SharoonSharif/conv3x3-engine-zynq/eval/results/bsds500_test_20_per_image.csv

precision | image | P_at_ODS | R_at_ODS | F_at_ODS | Pratt_at_ODS
fixed | 2018 | 0.6870364220081921 | 0.8612934767425618 | 0.764359054278603 | 0.5367017408046387
fixed | 16004 | 0.5290049942374183 | 0.8123926307683194 | 0.6407641566478511 | 0.32900443195014206
fixed | 36046 | 0.6471093302804808 | 0.7343235389086212 | 0.6879633807342148 | 0.24080708323318759
fixed | 49024 | 0.28222996515679444 | 0.30790378006872854 | 0.2945084019461837 | 0.07121425169083538
fixed | 71076 | 0.6425079702444209 | 0.750150908192943 | 0.6921694104170882 | 0.24130180233635037
fixed | 87015 | 0.378499296944906 | 0.9480286738351255 | 0.541003573892538 | 0.3462389215678983
fixed | 103006 | 0.26762669184765503 | 0.7504831436547134 | 0.3945533458570977 | 0.24670746153862197
fixed | 107072 | 0.46877335326144975 | 0.8884453890415219 | 0.6137249821704819 | 0.36808515852920093
fixed | 118072 | 0.48508339206013623 | 0.7509519779987307 | 0.5894238006223791 | 0.25748576975213117
fixed | 140088 | 0.8420616849513558 | 0.5967291351414271 | 0.6984792146009826 | 0.30735752032771074
fixed | 157087 | 0.5547136390474317 | 0.8610362237145238 | 0.6747357701685337 | 0.37057483303694283
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
