SharoonSharif/conv3x3-engine-zynq/eval/results/bsds500_test_all_per_image.csv

precision | image | P_at_ODS | R_at_ODS | F_at_ODS | Pratt_at_ODS
fixed | 2018 | 0.6797081526911283 | 0.874493644363738 | 0.7648948298438049 | 0.5549249914310739
fixed | 3063 | 0.9211590296495957 | 0.7142238579779173 | 0.8045990464312358 | 0.2166339705734296
fixed | 5096 | 0.49911504424778763 | 0.77013161985698 | 0.6056888521234021 | 0.3276910615426711
fixed | 6046 | 0.5028571428571429 | 0.9016730261226886 | 0.6456432645184711 | 0.37074812587136047
fixed | 8068 | 0.8209654178674352 | 0.8732321131447587 | 0.8462925409115006 | 0.322854539607317
fixed | 10081 | 0.6203842689882918 | 0.8049906670596326 | 0.7007328863391723 | 0.5168496925627778
fixed | 14085 | 0.6111111111111112 | 0.6960817429488262 | 0.6508347808610517 | 0.26806690602676225
fixed | 14092 | 0.4028791988316295 | 0.6016597510373444 | 0.48260189114375246 | 0.14596691010159193
fixed | 15011 | 0.6806006493506493 | 0.8952547452547452 | 0.77330821475178 | 0.35446340461068215
fixed | 15062 | 0.3157340201357996 | 0.6384375406213441 | 0.42251615872105236 | 0.23288722410679968
fixed | 16004 | 0.5271758436944938 | 0.8288016112789527 | 0.6444416713254187 | 0.352606839599231
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
