SharoonSharif/conv3x3-engine-zynq/eval/results/bsds500_test_all_prewitt_k2_per_image.csv

precision | image | P_at_ODS | R_at_ODS | F_at_ODS | Pratt_at_ODS | sat_frac
fixed | 2018 | 0.6750149670724407 | 0.8788937002374634 | 0.7635795006575489 | 0.5846174924994703 | 0.0
fixed | 3063 | 0.912358133669609 | 0.7154145919030093 | 0.8019723043817711 | 0.22852786240909428 | 0.0
fixed | 5096 | 0.5005750130684788 | 0.7803917504404602 | 0.6099215402048023 | 0.348458119525327 | 0.0
fixed | 6046 | 0.5116435074269287 | 0.9007337833871442 | 0.6525941689766143 | 0.38753120104410216 | 0.0
fixed | 8068 | 0.8163538873994638 | 0.8863352745424293 | 0.849906445738774 | 0.34466874244908935 | 0.0
fixed | 10081 | 0.6139112903225806 | 0.8131447096964338 | 0.6996203623993263 | 0.5292124793725987 | 0.0
fixed | 14085 | 0.6216216216216216 | 0.6679614929910488 | 0.6439589689860469 | 0.2507756605006652 | 0.0
fixed | 14092 | 0.4091643116673395 | 0.6063278008298755 | 0.4886058576294617 | 0.15287417466364034 | 0.0
fixed | 15011 | 0.6819984139571769 | 0.8905594405594406 | 0.7724486882968428 | 0.36418181490669854 | 0.0
fixed | 15062 | 0.31489136195018547 | 0.6560509554140127 | 0.4255346072871791 | 0.256494774234777 | 0.0
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
