SharoonSharif/conv3x3-engine-zynq/eval/results/bsds500_test_all_prewitt_k3_per_image.csv

precision | image | P_at_ODS | R_at_ODS | F_at_ODS | Pratt_at_ODS | sat_frac
fixed | 2018 | 0.6777241656614394 | 0.8726079061321413 | 0.7629171529023512 | 0.5824459388959009 | 0.0
fixed | 3063 | 0.9132052076875388 | 0.7167135743667461 | 0.803115561018505 | 0.23271766918081513 | 0.0
fixed | 5096 | 0.5008247422680412 | 0.7804953881231216 | 0.6101385474663937 | 0.35343947826349575 | 0.0
fixed | 6046 | 0.511439600790886 | 0.901496918109774 | 0.6526283633337003 | 0.39438064815626667 | 0.0
fixed | 8068 | 0.8211272359095512 | 0.8819675540765392 | 0.850460683808082 | 0.3444760943311227 | 0.0
fixed | 10081 | 0.6190063547082612 | 0.80970625798212 | 0.7016293055524357 | 0.5332193831138046 | 0.0
fixed | 14085 | 0.6234029608598661 | 0.669059280526938 | 0.6454247143401668 | 0.2558519263619676 | 0.0
fixed | 14092 | 0.4160944206008584 | 0.5816260373443983 | 0.4851285690053865 | 0.14622418645937404 | 0.0
fixed | 15011 | 0.6820959563125731 | 0.8913086913086913 | 0.7727930066649351 | 0.3702356348895659 | 0.0
fixed | 15062 | 0.3169050850997181 | 0.6567658910698038 | 0.4275211148202722 | 0.262339835768778 | 0.0
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
