SharoonSharif/conv3x3-engine-zynq/eval/results/bsds500_test_all_scharr_k4_per_image.csv

precision | image | P_at_ODS | R_at_ODS | F_at_ODS | Pratt_at_ODS | sat_frac
fixed | 2018 | 0.6628465079831521 | 0.8926526051124458 | 0.7607740270109483 | 0.5825778569263603 | 0.005064734036696654
fixed | 3063 | 0.9082217973231358 | 0.722342498376272 | 0.8046873145554555 | 0.2266778466379412 | 0.00042098172939294433
fixed | 5096 | 0.5310211946050096 | 0.699191626075241 | 0.6036119381864188 | 0.20113682737249083 | 0.0
fixed | 6046 | 0.4920664726316778 | 0.907601995890813 | 0.6381518519780623 | 0.3803395470771815 | 0.0005375612852248366
fixed | 8068 | 0.803946132164109 | 0.9000623960066556 | 0.8492934982581222 | 0.364008017963146 | 0.0023898808945537918
fixed | 10081 | 0.6683721811635399 | 0.736712840161116 | 0.7008805309239702 | 0.4362648380711895 | 0.0
fixed | 14085 | 0.6436866814924636 | 0.6466813038338118 | 0.6451805177772643 | 0.21625085037632757 | 1.9429925971982047e-05
fixed | 14092 | 0.4146212721034574 | 0.5608791493775933 | 0.47678590657740727 | 0.11848035793978087 | 1.2953283981321365e-05
fixed | 15011 | 0.69472049689441 | 0.8696303696303697 | 0.7723971078767066 | 0.3167606508794075 | 0.00012953283981321365
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
