SharoonSharif/conv3x3-engine-zynq/eval/results/bsds500_test_all_scharr_k5_per_image.csv

precision | image | P_at_ODS | R_at_ODS | F_at_ODS | Pratt_at_ODS | sat_frac
fixed | 2018 | 0.6756785984643668 | 0.8775666992596731 | 0.7635021181569023 | 0.5405552394391189 | 0.0
fixed | 3063 | 0.9166097060833903 | 0.7154145919030093 | 0.8036105340111189 | 0.21342775529360913 | 0.0
fixed | 5096 | 0.5008580253975518 | 0.7710125401596021 | 0.6072438955326005 | 0.31751259380209845 | 0.0
fixed | 6046 | 0.49704200354959577 | 0.9027296742001761 | 0.6410967917988402 | 0.3657329936315141 | 0.0
fixed | 8068 | 0.819672131147541 | 0.8714642262895175 | 0.8447750962721023 | 0.3114487030028486 | 0.0
fixed | 10081 | 0.6248069199876429 | 0.8037135278514589 | 0.7030571731036686 | 0.5050235559599526 | 0.0
fixed | 14085 | 0.6026047166490672 | 0.725553116027698 | 0.6583882113115176 | 0.28519273614484775 | 0.0
fixed | 14092 | 0.38481529608316317 | 0.627204356846473 | 0.47698249650751917 | 0.15670895133371696 | 0.0
fixed | 15011 | 0.6740809802876931 | 0.9012987012987013 | 0.7713039836741542 | 0.35709215425261776 | 0.0
fixed | 15062 | 0.31274086184748334 | 0.6423371896529312 | 0.42066737053199027 | 0.231419704938899 | 0.0
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
