SharoonSharif/conv3x3-engine-zynq/eval/results/fig10.png

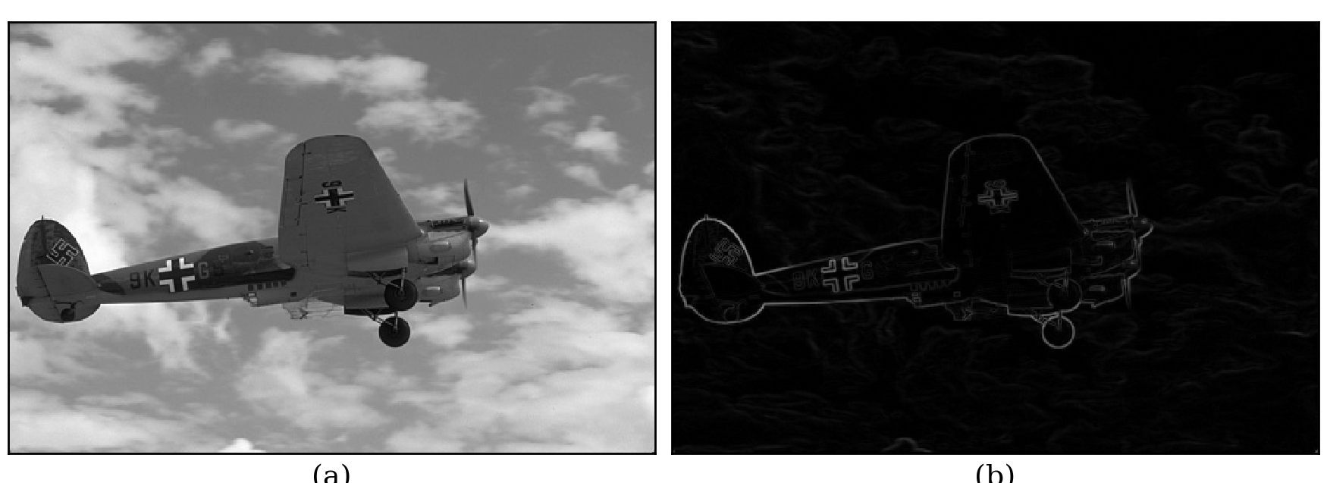
eval/results/fig10.png
