SharoonSharif/conv3x3-engine-zynq/(commit log)

2026-09-29 Initial artifact release: conv3x3 engine + fixed Sobel for XC7Z020-1
    Reconstructed RTL (original sources lost), self-checking testbenches with
    random AXI4-Stream backpressure, fixed-point golden model, Vivado 2026.1
    out-of-context scripts, and post-route reports at W=160 (the builds the
    manuscript table was drawn from) and W=1920.
    Known and documented in README: the manuscript's LUT figures (x + 595
    memory) match no report; the published numbers are the W=160 build; at
    W=1920 the engine misses 148.5 MHz by 86 ps; the BSDS500 evaluation code and
    the DDR model are not included; no board-level runs were executed.
    [conv3x3_engine.v, sobel_fixed.v, tb_engine.v, tb_sobel_fixed.v]
2026-09-30 Add 1920-pixel evidence: ExtraTimingOpt closure, extended simulation
    - synth/ooc_synth_strategy.tcl and reports/W1920_extratiming: both cores
    close 148.5 MHz at W=1920 (Sobel +0.290 ns, engine +0.066 ns) with no RTL
    change; default-flow W=1920 reports moved to reports/W1920_default.
    - tb/tb_engine_ext.v: any frame size, full-rate AXI4-Stream source,
    mid-frame kernel rewrites, throughput measurement. 12 runs bit-exact at
    160x120, 1920x16 and 1920x1080 (logs in tb/logs_ext).
    - golden/gen_vectors_wide.py for arbitrary-size vectors.
    - README/docs: results for all builds, history of the originally submitted
    numbers, verification table, DOI; CITATION.cff and .zenodo.json v1.1.0.
2026-09-30 Add BSDS500 evaluation (re-implemented) and DDR model script
    - eval/bsds_eval.py: fixed-point (bit-exact to RTL) vs float64 Sobel on the
    200-image BSDS500 test split, relaxed matching (0.0075 diag, no
    one-to-one), ODS/OIS/Pratt. Fixed ODS 0.589 / OIS 0.599 / Pratt
    0.304+/-0.108; float64 0.589 / 0.600 / 0.291+/-0.106. Results in
    eval/results/. BSDS500 is not redistributed.
    - eval/make_fig10.py regenerates the brief's image-3063 figure.
    - model/ddr_model.py reproduces the brief's Tables I and II.
    - Docs and metadata updated accordingly.
    [bsds500_test_20_per_image.csv, bsds500_test_all_per_image.csv]
2026-09-30 Engine v1.2: signed single-kernel mode, immediate EN, registered lrep; Vitis Vision baseline
    RTL (conv3x3_engine.v):
    - CTRL bit 2 SIGNED: single-kernel output clamp(acc1 >> k, 0, 255), so
    sharpening behaves conventionally (reset 0 keeps the rectified mode).
    - EN is no longer shadowed: EN = 0 pauses input immediately, EN = 1 resumes
    (previously EN = 0 was sticky until reset).
    - Left-border flag lrep registered with the push counter; cycle-identical,
    removes the compare from the window-mux -> DSP path. W = 1920 now meets
    148.5 MHz with default directives (+0.076 ns, 1,916 LUT, 816 FF, 18 DSP).
    sobel_fixed.v unchanged.
    Verification: 6 kernels (adds Prewitt and signed sharpen), mid-fram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
    [conv3x3_engine.v, tb_engine.v, tb_engine_ext.v]
2026-10-05 Add Vitis Vision Sobel baseline (compare/vitis_sobel)
    Like-for-like vendor baseline for rtl/sobel_fixed.v: AXIvideo2xfMat ->
    xf::cv::Sobel<XF_BORDER_CONSTANT, 3x3, XF_8UC1 -> XF_16SC1, 1080x1920,
    NPPC1> -> combine stage clamp((|gx|+|gy|)>>3, 0, 255) -> xfMat2AXIvideo,
    rows/cols on AXI4-Lite, HLS DATAFLOW. C simulation (MinGW g++) matches
    exp_sobel.hex on all 18,644 interior pixels of the 160x120 scene (borders
    differ by design: zero padding vs edge replication). Vitis HLS 2026.1
    csynth and Vivado 2026.1 out-of-context implementation (default
    directives, 6.734 ns) reports included, host name and paths redacted.
2026-10-05 vitis_sobel: csynth and Vivado OOC reports (default directives), README with results
    sobel_top: 845 LUT (842 logic + 3 SRL, 0 LUTRAM), 1,163 FF, 3 RAMB18,
    0 DSP, WNS +0.926 ns at 6.734 ns, 0.124 W (0.021 W dynamic). HLS latency
    2,090,653 cycles (1080p worst case, LOOP_TRIPCOUNT min=max), Col_Loop
    II = 1. C-sim: 0 / 18,644 interior mismatches vs exp_sobel.hex. The v0
    csynth report (flattened combine loop, 1 DSP) is kept for the record.
2026-10-05 eval: add --kernel {sobel,prewitt,scharr} and --k to bsds_eval.py; sensitivity driver
    bsds_eval.py: fixed = clamp((|Gx|+|Gy|) >> k, 0, 255) (int64), float64 =
    (|Gx|+|Gy|) / 2**k; records the fraction of pixels clipped at 255 before
    NMS. Outputs bsds500_test_<subset>_<kernel>_k<k>.{json,_per_image.csv};
    for the default (sobel, k=3) the original file names are also written in
    the original schema, byte-identical to the previous output (verified with
    --subset 20 and the full split). Kernels come from golden/gen_vectors.CASES.
    run_sensitivity.py: runs the 10 E4 settings (4 at a time) and aggregates
    results/sensitivity.{json,md}.
2026-10-05 eval/results: BSDS500 k / kernel sensitivity (10 settings, 200 test images)
    sobel k=0..5, prewitt k=2,3, scharr k=4,5; fixed vs float64, saturation
    fractions; logs redacted (host name, absolute paths).
    [bsds500_test_all_prewitt_k2_per_image.csv, bsds500_test_all_prewitt_k3_per_image.csv, bsds500_test_all_scharr_k4_per_image.csv, bsds500_test_all_scharr_k5_per_image.csv, bsds500_test_all_sobel_k0_per_image.csv, bsds500_test_all_sobel_k1_per_image.csv, bsds500_test_all_sobel_k2_per_image.csv, bsds500_test_all_sobel_k3_per_image.csv]
2026-10-05 tb_engine_ext: long-run (+FRAMES), +NOSWAP, +ADVERSARIAL stalls/gaps, latency report; add tb/run_xsim_long.bat
    Existing 2-frame modes and plusargs are unchanged (same random sequences,
    same cycle counts). +FRAMES=N streams N frames back to back with the kernel
    rotating scharr, prewitt, gaussian, laplacian, sharpen, sobel, each written
    mid-frame at an LFSR-chosen input row and every frame checked against its own
    expected image. +ADVERSARIAL holds m_axis_tready low for 1000..2000 cycles
    starting in the SOF accept cycle (engine idle) or the cycle after (back to
    back) and at the first EOL, and inserts 500..1499-cycle input gaps mid-line.
    Reports frame-1 latency, cycles per frame, pixels checked,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
    [tb_engine_ext.v]
2026-10-05 Add long-run/adversarial xsim logs: 6 runs, 26,956,800 px, 184 kernel swaps, 0 mismatches; regenerate logs_ext
    a 1920x16 x60 adversarial, b 160x120 x120 adversarial, c 1920x1080 x4 full
    rate, d 1920x1080 x3 adversarial, e/f 1920x1080 x2 full rate without/with a
    mid-frame swap (identical 2,076,604 cycles per frame, 1,926-cycle latency).
    The 25 existing runs still pass; tb/logs_ext regenerated with the new
    testbench (same numbers plus the latency line).
2026-10-05 E2 Part B: LB_BRAM parameter (block-RAM line buffers) for conv3x3_engine
    LB_BRAM=0 (default) keeps today's code path at module scope; LB_BRAM=1 adds a
    generate block with ram_style=block buffers read one cycle early (registered
    read, address col_in+1 / col_ff+1 / 0, shared clock enable), with the synthetic
    bottom row pushed in permuted tap slots (brow_q) so Vivado infers RAMB18.
    synth/ooc_synth_param.tcl: optional 5th tclarg sets the LB_BRAM generic
    (4-arg behaviour unchanged). Testbenches: -d TB_LB_BRAM=<0|1>;
    tb/run_xsim_bram.bat repeats all engine runs with LB_BRAM=1.
2026-10-05 E2 Part B: W=1920 gate (LB_BRAM=0 identical to baseline) and LB_BRAM=1 build + 24 xsim logs
    LB_BRAM=0 rebuild: 1,916 LUT (892 + 1,024) / 816 FF / 18 DSP / +0.076 ns, reports line-identical.
    LB_BRAM=1: 702 LUT (702 + 0 LUTRAM) / 624 FF / 2 RAMB18 / 18 DSP / +0.044 ns / 0.156 W.
    All 24 LB_BRAM=1 simulations pass; cycles per frame unchanged.
2026-10-05 Archive Vitis Sobel HLS loop reports and both C-simulation logs; register-map notes (whole-word CTRL writes, PENDING corner case); fix 190->192 FF and <=0.0006 ODS bound; drop stray .hls.failed; add 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
